emtiazahmed01/Water-Level-Monitoring-and-Smart-Pump-Control-System/Diagram.jpg

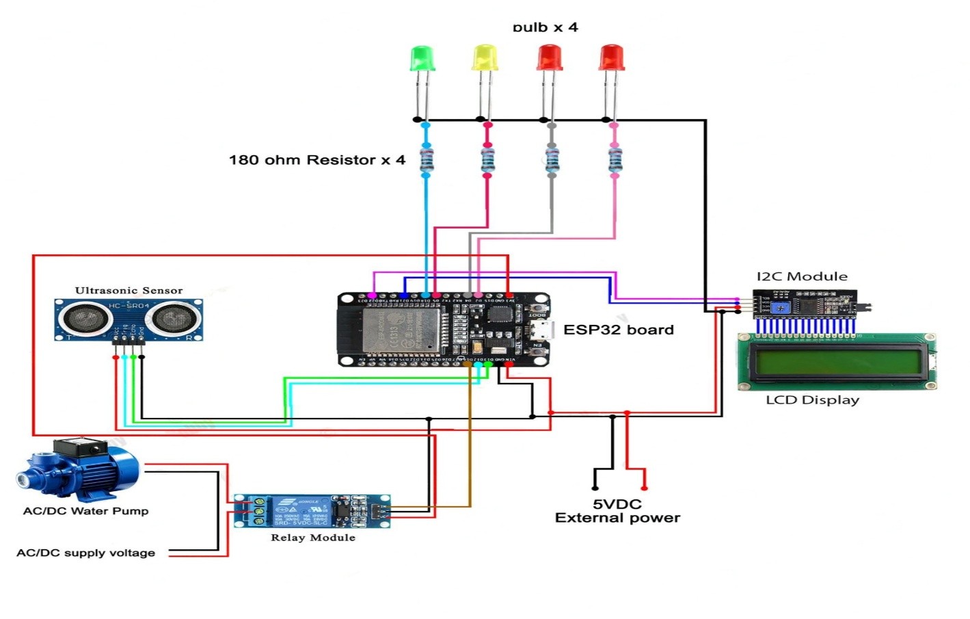
Diagram.jpg
