emtiazahmed01/Water-Level-Monitoring-and-Smart-Pump-Control-System/(notices)

Notices in the files:
README.md:
License: MIT
